Wojwos/VisualMemory/board.brd

## EAGLE design board.brd (2022-03-13)

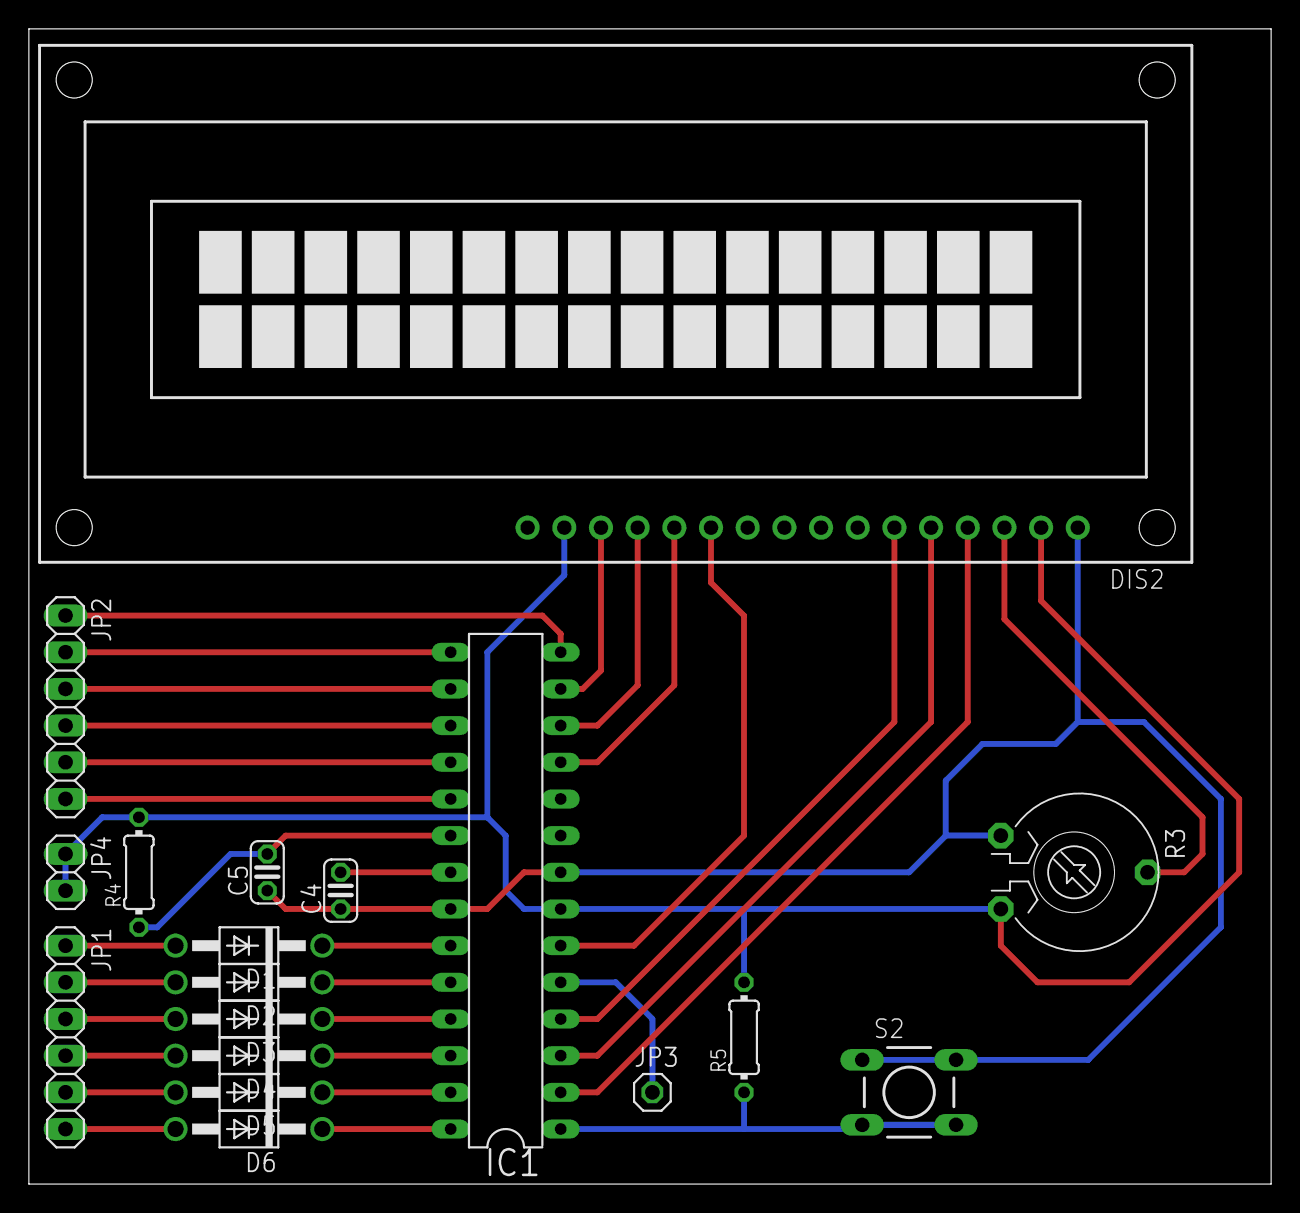
[picture p12: board board.brd from above]

Board: 2 copper layers, 86.0 x 80.0 mm, 18 parts (0 on the bottom side), 32 nets.

Parts:
C4, C5: 100nF; C025-024X044
D1, D2, D3, D4, D5, D6: 1N4004; DO41-10
DIS2: TUXGR_16X2_R2
IC1: ATMEGA328-20P; DIL28-3
JP1, JP2: 1X06
JP3: 1X01
JP4: 1X02
R3: 10K; PT-10
R4, R5: 10K; 0204/7
S2: DTS-6

Connections:
GND: C4.1, C5.1, DIS2.1, IC1.8, IC1.22, R3.1, S2.1, S2.2
unnamed: D1.C, IC1.23
unnamed: D2.C, IC1.24
unnamed: DIS2.3, R3.3
unnamed: DIS2.6, IC1.4
unnamed: C5.2, IC1.20, R4.1
unnamed: DIS2.5, IC1.3
unnamed: IC1.5, JP3.1
unnamed: DIS2.11, IC1.6
unnamed: DIS2.12, IC1.11
unnamed: DIS2.13, IC1.12
unnamed: DIS2.14, IC1.13
unnamed: IC1.1, R5.1, S2.3, S2.4
unnamed: DIS2.4, IC1.2
unnamed: C4.2, IC1.21
unnamed: D3.C, IC1.25
unnamed: D4.C, IC1.26
unnamed: D5.C, IC1.27
unnamed: D6.C, IC1.28
unnamed: IC1.14, JP2.1
unnamed: IC1.15, JP2.2
unnamed: IC1.16, JP2.3
unnamed: IC1.17, JP2.4
unnamed: IC1.18, JP2.5
unnamed: IC1.19, JP2.6
unnamed: D1.A, JP1.1
unnamed: D2.A, JP1.2
unnamed: D3.A, JP1.3
unnamed: D4.A, JP1.4
unnamed: D5.A, JP1.5
unnamed: D6.A, JP1.6
unnamed: DIS2.2, DIS2.15, IC1.7, JP4.1, JP4.2, R3.2, R4.2, R5.2
